raghavambashta/Color-Sorting-Machine/Color Sorting Machine/Pics/Components.jpg

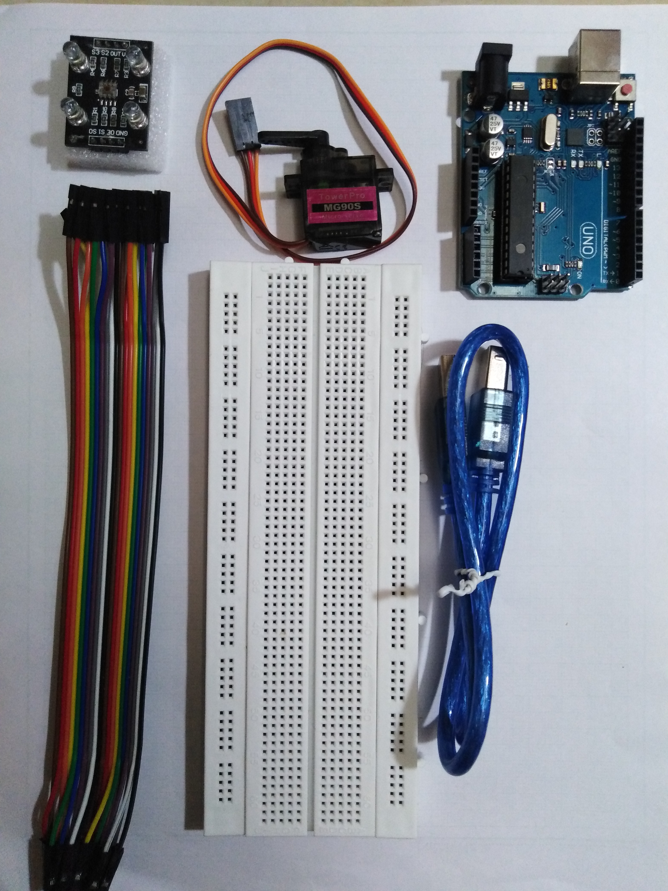
Color Sorting Machine/Pics/Components.jpg
