raghavambashta/Color-Sorting-Machine/Color Sorting Machine/Pics/Final Structure with Labeling.jpeg

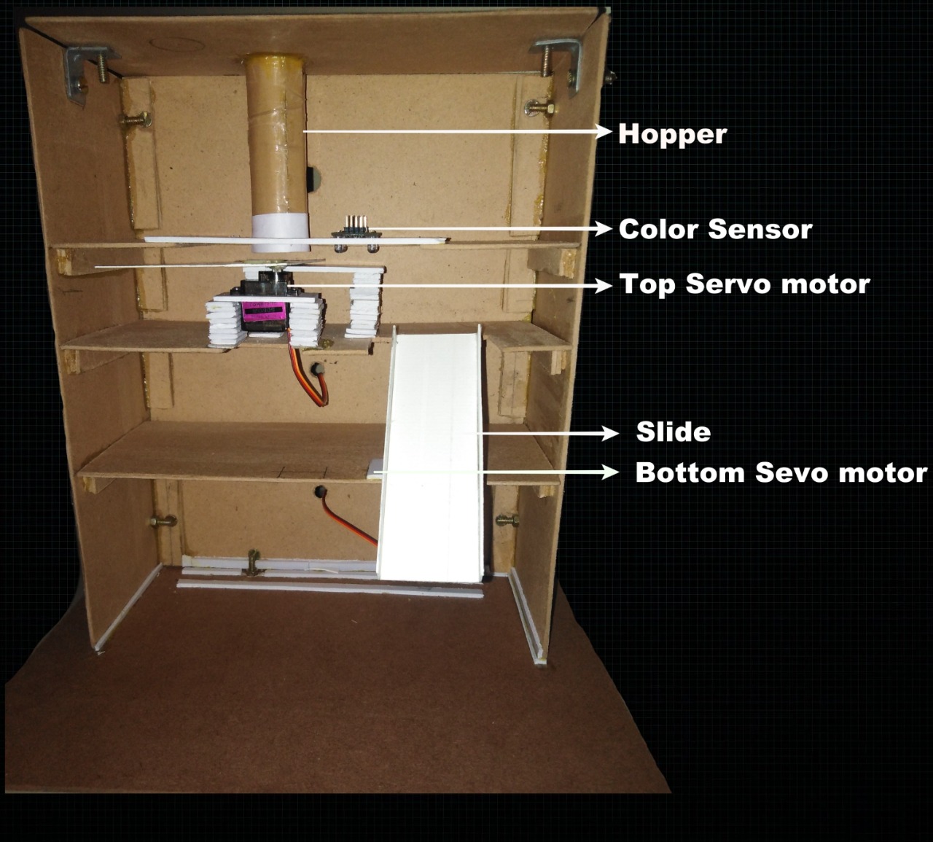
Color Sorting Machine/Pics/Final Structure with Labeling.jpeg
