raghavambashta/Color-Sorting-Machine/Color Sorting Machine/Pics/Final Structure.jpg

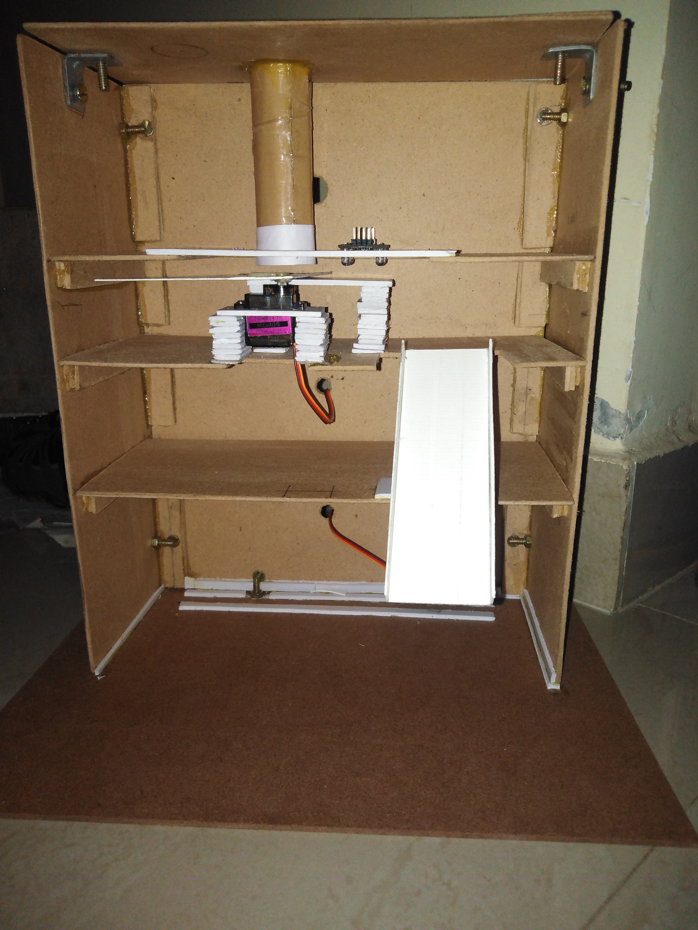
Color Sorting Machine/Pics/Final Structure.jpg
