raghavambashta/Color-Sorting-Machine/Color Sorting Machine/Pics/Platform.jpg

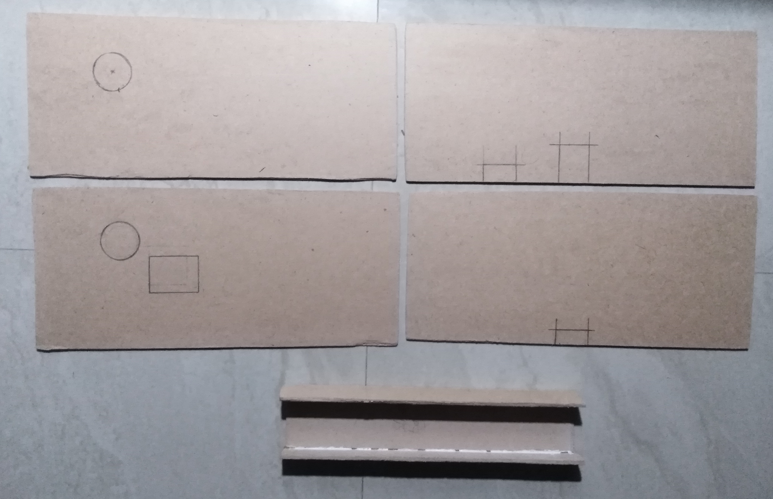
Color Sorting Machine/Pics/Platform.jpg
