raghavambashta/Color-Sorting-Machine/Color Sorting Machine/Pics/Side Panels.jpg

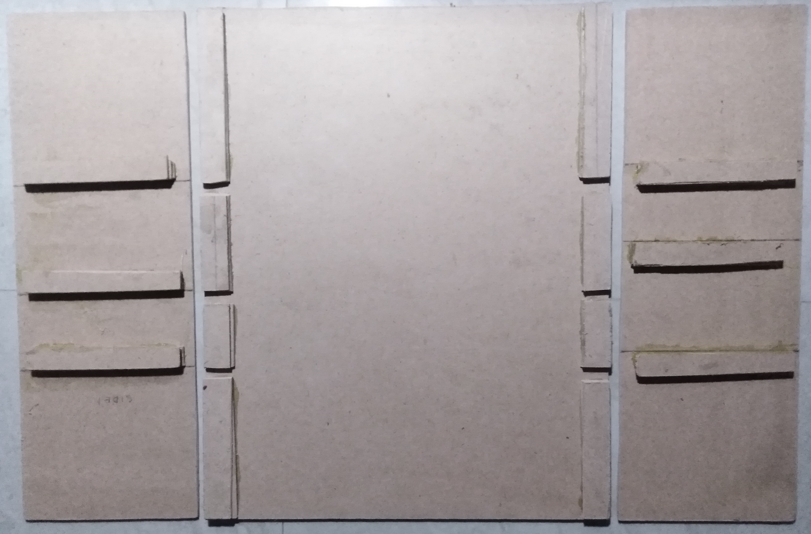
Color Sorting Machine/Pics/Side Panels.jpg
